Doom956/Robocup-Junoir-Theseus/outputs/original-poster-source.png

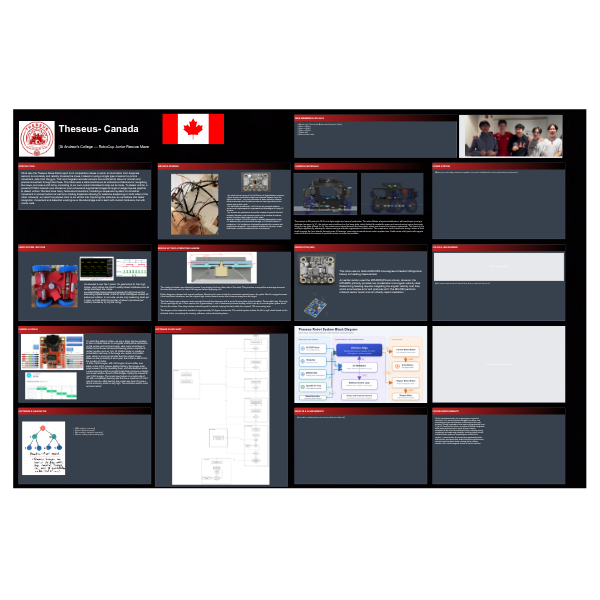
outputs/original-poster-source.png
