Doom956/Robocup-Junoir-Theseus/outputs/diagrams/chrome-profile/Default/README

Google Chrome settings and storage represent user-selected preferences and information and MUST not be extracted, overwritten or modified except through Google Chrome defined APIs.
