Doom956/Robocup-Junoir-Theseus/outputs/diagrams/theseus-system-block-diagram.png

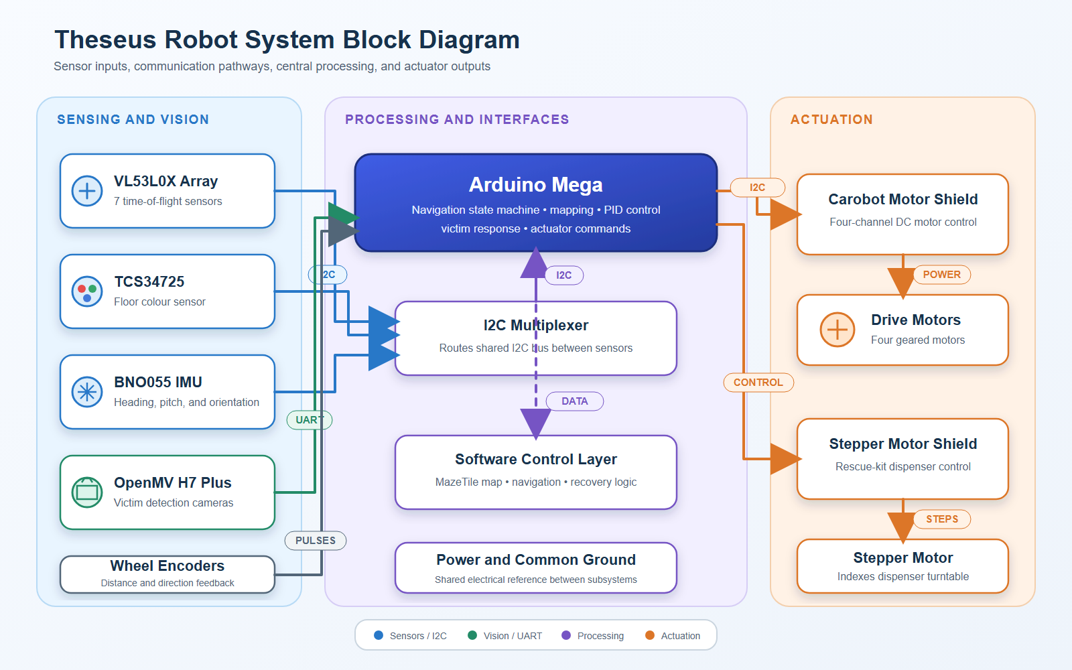
outputs/diagrams/theseus-system-block-diagram.png
