Doom956/Robocup-Junoir-Theseus/outputs/priced-bom/Electronics_Sensor_BOM_Priced.xlsx

Sheet: Summary
Electronics and Sensor Bill of Materials
Prices checked June 12, 2026 | USD unless stated | Tax and shipping excluded
Metric | Value
Partial priced subtotal | $631.07
BOM line items | 23
Rows without complete USD cost | 12
Pricing Notes
The subtotal includes only items with a numeric required quantity and a USD unit price.
Representative prices are assumptions and must be confirmed before ordering.
The CAROBOT shield is listed at CAD $19.99 and is excluded from the USD subtotal.
Resolve the spreadsheet's 150:1 gearmotor description against linked Pololu item 3493, which is 195:1.

Sheet: BOM
Category | Component / Description | Supplier | Status | Type | Required Qty | Existing Qty | Spare Qty | Unit Price (USD) | Required Cost (USD) | Pricing Basis | Assumptions / Follow-up | Source URL
Processing | Processor/controller board (exact model TBD) | Supplier TBD | Reused; existing inventory | Kit/off-the-shelf | 0 | 2 | 1 |  |  | TBD | Exact model required
Sensor | Adafruit VL53L0X time-of-flight sensor breakout, PID 3317 | Adafruit | Reused; existing inventory | Kit/off-the-shelf | 7 | 14 | 1 | $14.95 | $104.65 | Exact | PID 3317 | https://www.adafruit.com/product/3317
Sensor | Adafruit TCS34725 color sensor breakout, PID 1334 | Adafruit | Reused; existing inventory | Kit/off-the-shelf | 1 | 2 | 0 | $7.95 | $7.95 | Listed; discontinued | Discontinued listing | https://www.adafruit.com/product/1334
Sensor | Adafruit BNO055 absolute-orientation sensor breakout, PID 2472 | Adafruit | Reused; existing inventory | Kit/off-the-shelf | 1 | 2 | 0 | $34.95 | $34.95 | Exact | PID 2472 | https://www.adafruit.com/product/2472
Sensor | Motor encoders; assumed Pololu 20D magnetic encoder pair kit, item 3499 | Pololu | Reused; spare inventory; installed quantity unknown | Kit/off-the-shelf | 2 |  | 1 | $9.95 | $19.90 | Representative | Quantity is pair kits; confirm installed model | https://www.pololu.com/product/3499
Vision | OpenMV Cam H7 Plus, SKU OMV-CAM-H7-PLUS-V1 | OpenMV | Reused; existing inventory | Kit/off-the-shelf | 2 | 4 | 0 | $135.00 | $270.00 | Exact; sold out | Production-run order only | https://openmv.io/products/openmv-cam-h7-plus
Actuator | Pololu extended-shaft gearmotor; linked item 3493 is 195:1 | Pololu | Reused; existing inventory | Kit/off-the-shelf | 4 | 8 | 1 | $32.95 | $131.80 | Linked model | Spreadsheet says 150:1; confirm ratio/model | https://www.pololu.com/product/3493
Actuator | 28BYJ-style 5 V geared stepper motor; assumed Adafruit PID 858 | Adafruit | Reused; existing and spare inventory | Kit/off-the-shelf | 1 | 2 | 4 | $4.95 | $4.95 | Representative; out of stock | Confirm exact model | https://www.adafruit.com/product/858
Display | LCD screen (exact model and size TBD) | Supplier TBD | Reused; existing and spare inventory | Kit/off-the-shelf | 1 | 1 | 1 |  |  | TBD | Exact model and size required
Lighting | LED strips (type/length TBD) | Supplier TBD | Reused; existing inventory | Kit/off-the-shelf | 3 | 3 | 0 |  |  | TBD | Type, voltage, density, and length required
Mechanical | M4 suspension screws (length/type TBD) | Supplier TBD | Reused; existing inventory | Kit/off-the-shelf | 1 | 2 | 0 |  |  | TBD | Price is per required set; specification required
Mechanical | Ball bearings (size/model TBD) | Supplier TBD | Reused; existing and spare inventory | Kit/off-the-shelf | 2 | 4 | 5 |  |  | TBD | Size/model required
Mechanical | Motor brackets (exact model TBD) | Supplier TBD | Reused; existing and spare inventory | Kit/off-the-shelf | 4 | 8 | 6 |  |  | TBD | Exact model required
Electronics | Protoboard; assumed Adafruit half-size Perma-Proto, PID 1609 | Adafruit | Reused; existing and spare inventory | Kit/off-the-shelf | 1 | 2 | 1 | $4.50 | $4.50 | Representative | Confirm dimensions | https://www.adafruit.com/product/1609
Wiring | Qwiic cables; assumed 100 mm JST-SH 4-pin, Adafruit PID 4210 | Adafruit | Reused; existing inventory | Kit/off-the-shelf | 10 | 18 | 0 | $0.95 | $9.50 | Representative | Confirm lengths | https://www.adafruit.com/product/4210
Safety/electronics | Circuit breaker (rating/model TBD) | Supplier TBD | Reused; existing and spare inventory | Kit/off-the-shelf | 1 | 1 | 3 |  |  | TBD | Rating/model required
Wiring | Wire clips (type and quantity TBD) | Supplier TBD | Inventory status TBD | Kit/off-the-shelf |  |  |  |  |  | TBD | Type and quantity required
Wiring | JST-PH cables; assumed Pololu 6-pin female-female 10 cm, item 5643 | Pololu | Reused; existing and spare inventory | Kit/off-the-shelf | 4 | 8 | 2 | $3.23 | $12.92 | Representative | Confirm pin count and length | https://www.pololu.com/category/361/6-pin-jst-ph-style-cables
Power | Pololu D24V50F5 5 V step-down voltage regulator, item 2851 | Pololu | Reused; existing inventory; verify possible school spares | Kit/off-the-shelf | 1 | 1 | 0 | $29.95 | $29.95 | Exact | Item 2851 | https://www.pololu.com/product/2851
Control | CAROBOT Motor Shield V3, SKU 2337 | Canada Robotix | Reused; quantity must be verified | Kit/off-the-shelf |  |  |  |  |  | CAD price only | CAD $19.99; USD price and required quantity TBD | https://www.canadarobotix.com/products/2337
Control | SparkFun Qwiic Mux Breakout - 8 Channel (TCA9548A), BOB-16784 | SparkFun | Reused; quantity must be verified | Kit/off-the-shelf |  |  |  | $6.95 |  | Exact | Required quantity TBD | https://www.sparkfun.com/sparkfun-qwiic-mux-breakout-8-channel-tca9548a.html
Power | LiPo battery (voltage, capacity, and model TBD) | Supplier TBD | Reused; quantity and condition must be verified | Kit/off-the-shelf |  |  |  |  |  | TBD | Voltage, capacity, model, and quantity required
Assembly | Robot mechanical structure and wiring assembly | Team designed and assembled | Reused; verify current configuration | Custom-built | 1 |  |  |  |  | TBD | Material costs TBD
