Doom956/Robocup-Junoir-Theseus/docs/BoM for worlds.xlsx

Sensors:
 | Need(What we need) | existing(how many already exist on the robots) | Spare(how many we have extra not on the robot) | Unit price / listed currency | Price source / assumption | Price checked
Processors | 0 | 2 | 1 | TBD | Exact processor/controller model required | 2026-06-12
Sensors:
Vl53L0X | 7 | 14 | 1 | $14.95 | Adafruit PID 3317: https://www.adafruit.com/product/3317 | 2026-06-12
TCS34725 | 1 | 2 | 0 | $7.95 | Adafruit PID 1334; discontinued: https://www.adafruit.com/product/1334 | 2026-06-12
BNO055 | 1 | 2 | 0 | $34.95 | Adafruit PID 2472: https://www.adafruit.com/product/2472 | 2026-06-12
Encoders | 2(packs) | ? | 1(pack) | $9.95 | Representative: Pololu item 3499 encoder pair kit; confirm model: https://www.pololu.com/product/3499 | 2026-06-12
Openmv h7 plus | 2 | 4 | 0 | $135.00 | OpenMV H7 Plus; sold out / production-run order only: https://openmv.io/products/openmv-cam-h7-plus | 2026-06-12
Actuators:
150:1 Polulu gearmotor with extended shafts | 4 | 8 | 1 | $32.95 | Linked Pololu item 3493 is 195:1, not spreadsheet's 150:1; confirm model: https://www.pololu.com/product/3493 | 2026-06-12
28BYJ-49 stepper motor | 1 | 2 | 4 at my house | $4.95 | Representative: Adafruit PID 858; out of stock; confirm exact model: https://www.adafruit.com/product/858 | 2026-06-12
LCD screen | 1 | 1 | 1 at my house | TBD | Exact LCD model and size required | 2026-06-12
LED strips | 3 | 3 | 0 | TBD | LED strip type, voltage, density, and length required | 2026-06-12
Mechanical&wiring | 3
M4 screws for suspension | 1 | 2 | 0 | TBD | M4 screw length, head type, and pack size required | 2026-06-12
Ball Bearings | 2 | 4 | 5 | TBD | Bearing size/model required | 2026-06-12
Motor Brackets | 4 | 8 | 6 | TBD | Motor bracket model required | 2026-06-12
Protoboard | 1 | 2 | 1 | $4.50 | Representative: Adafruit half-size Perma-Proto PID 1609; confirm dimensions: https://www.adafruit.com/product/1609 | 2026-06-12
Qwiic cables | 10 | 18 | 0 | $0.95 | Assumption: Adafruit PID 4210 100mm Qwiic cable; confirm lengths: https://www.adafruit.com/product/4210 | 2026-06-12
Circuit breaker | 1 | 1 | 3 | TBD | Circuit-breaker rating/model required | 2026-06-12
Wire clips | ??? | ??? | ??? | TBD | Wire-clip type and quantity required | 2026-06-12
JST-PH | 4 | 8 | 2 | $3.23 | Representative: Pololu item 5643 6-pin JST-PH female-female 10cm; confirm pin count/length: https://www.pololu.com/category/361/6-pin-jst-ph-style-cables | 2026-06-12
D24V50F5 5V step-down regulator | 1 | 1 | 0( May be some at the school) | $29.95 | Pololu item 2851: https://www.pololu.com/product/2851 | 2026-06-12
