Doom956/Robocup-Junoir-Theseus/outputs/diagrams/theseus-system-block-diagram.pdf

# Theseus Robot System Block Diagram

## VL53L0X Array

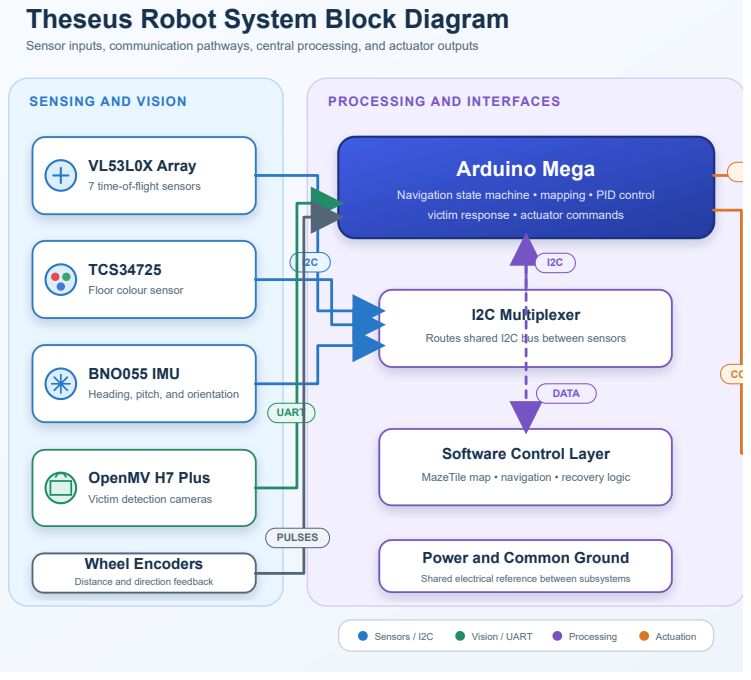
[picture p12: page 1]
SENSING AND VISION; PROCESSING AND INTERFACES; Arduino Mega; I2C Multiplexer; UART; PULSES; DATA; Sensors / I2C; Vision / UART; Processing; Actuation

Sensor inputs, communication pathways, central processing, and actuator outputs

7 time-of-flight sensors

Navigation state machine • mapping • PID control
victim response • actuator commands

TCS34725
Floor colour sensor

Routes shared I2C bus between sensors

BNO055 IMU
Heading, pitch, and orientation

Software Control Layer

OpenMV H7 Plus
Victim detection cameras

MazeTile map • navigation • recovery logic

Wheel Encoders
Distance and direction feedback

Power and Common Ground

Shared electrical reference between subsystems
