Doom956/Robocup-Junoir-Theseus/Main/uart_camera_comms.ino

// camera communication code
// clear serial buffers.

void lcdPrint(const char* msg) {
  lcdMutex.lock();
  lcd.setCursor(0, 0);
  lcd.print("                ");
  lcd.print("                ");
  lcd.setCursor(0, 0);
  lcd.print(msg);
  delay(1000);
  lcd.setCursor(0, 0);
  lcd.print("                ");
  lcd.print("                ");
  lcd.setCursor(0, 0);
  lcdMutex.unlock();
}

void clearSerialBuffer1() {
  while (Serial4.available() > 0) {
    Serial4.read();  // Read and discard one byte from the buffer
  }
}
void clearSerialBuffer2() {
  while (Serial3.available() > 0) {
    Serial3.read();  // Read and discard one byte from the buffer
  }
}

// classify a single camera byte: H/S/U = victim (0/1/2),
// L/c/I = camera "searching"/circle signal (-2), anything else -2.
int classifyCamByte(char sample){
  if(sample == 'H') return 0;
  if(sample == 'S') return 1;
  if(sample == 'U') return 2;
  return -2; // L / c / I / stray byte -> not a lettered victim
}
int readSerial1(){ // left
  // The camera streams continuously, so the RX FIFO backs up while we move.
  // Drain everything and keep only the NEWEST byte so we react to what the
  // camera sees now, not a byte from several frames (and tiles) ago.
  if(Serial4.available() <= 0) return -1; // nothing right now
  char sample = 0;
  while(Serial4.available() > 0){
    sample = Serial4.read();
  }
  return classifyCamByte(sample);
}
int readSerial2(){ //right
  if(Serial3.available() <= 0) return -1; // nothing right now
  char sample = 0;
  while(Serial3.available() > 0){
    sample = Serial3.read();
  }
  return classifyCamByte(sample);
}
void detectCam1(){ // left camera serial4
   // read buffer
  // if there is content, take 5 samples and take the most common letter.
  int samples[5];
  int n = 0;
  int maxCount = 0;
  char res = 0;
  char output;
  timer myTimer;
  while(n<5){
    if(myTimer.getTime() > 4*1000000) return;
    
    int value = readSerial1();
    
    if(value >= 0){   // only H/S/U
        samples[n] = value;
        Serial.println(value);
        n++;
    }
  }
  for(int i =0; i<5;i++){
    Serial.println(samples[i]);
  }
  
  for(int i=0;i<6;i++){
    int count = 0;
    for(int j = 0;j<5;j++){
      if(samples[j] == i) count++;
    }
    if(count > maxCount){
      maxCount = count;
      res = classes[i];
    }
  }
  
  char msg[17]; snprintf(msg, sizeof(msg), "victim: %c", res);
  lcdPrint(msg);
  
  disp.dispenseLeft(res);
  return;
}
void detectCam2(){
  // read buffer
  // if there is content, take 5 samples and take the most common letter.
  int samples[5];
  int n = 0;
  int maxCount = 0;
  char res = 0;
  char output;
  timer myTimer;
  while(n<5){
    if(myTimer.getTime() > 4*1000000) return;
    
    int value = readSerial2();

    if(value >= 0){   // only H/S/U
        samples[n] = value;
        Serial.println(value);
        n++;
    }
  }
  for(int i =0; i<5;i++){
    Serial.println(samples[i]);
  }
  
  for(int i=0;i<6;i++){
    int count = 0;
    for(int j = 0;j<5;j++){
      if(samples[j] == i) count++;
    }
    if(count > maxCount){
      maxCount = count;
      res = classes[i];
    }
  }
  char msg[17]; snprintf(msg, sizeof(msg), "victim: %c", res);
  lcdPrint(msg);
  
  disp.dispenseRight(res);
  return;
}
// Service a camera victim that the RTOS thread flagged via victimPending.
// The caller (fwd/absoluteturn) has already paused its PID + timer. This stops
// the drivetrain, identifies the victim on the wall, dispenses the rescue kit,
// and labels the correct tile using the encoder position. (claude version 6/16/2026)
// serviceCameraVictim() is outside to prevent I2C conflict with centered.
void serviceCameraVictim(){
  drivetrain.fullstop();
  if(victimSide == 1){            // left camera (Serial3)
    if(detectWall(3) == 0){       // RCJ victims are wall-mounted
      Serial.println("victim at left");
      clearSerialBuffer1();
      detectCam1();
      markVictimAtEncoderPosition(TILE_MM);
      victimtoggle = true;
    }
  }
  else if(victimSide == 2){       // right camera (Serial2)
    if(detectWall(1) == 0){
      Serial.println("victim at right");
      clearSerialBuffer2();
      detectCam2();
      markVictimAtEncoderPosition(TILE_MM);
      victimtoggle = true;
    }
  }
  isVictim = true;       // at most one victim serviced per move
  victimPending = false; // re-enable the camera thread
}
void detect(){ // the robot goes forward until it detects something( does not return)
  drivetrain.fullstop();
  bool victimAtLeft = false; // victim at left
  bool victimAtRight = false; // victim at right
  // clear buffers
  clearSerialBuffer1();
  clearSerialBuffer2();
  // don't detect if there is no wall( prevent misdetection)
  bool wallAtLeft = false;
  bool wallAtRight = false;
  int right = measure(3);
  int left = measure(6);
  if(right <MIN_DIST&&right!=-1) wallAtRight = true;
  if(left<MIN_DIST&&right!=-1) wallAtLeft = true;
  if(wallAtRight == false && wallAtLeft == false) return;
  timer myTimer;
  while(true){
    if(readSerial1() != -1&&wallAtLeft == true){
      Serial.println("left");
      victimAtLeft = true;
      victimtoggle = true;
      break;
    }
    if(readSerial2() != -1&&wallAtRight == true){
      Serial.println("right");
      victimAtRight = true;
      victimtoggle = true;
      break;
    }
    if(myTimer.getTime() >= 1000000*1.2) break; // give 1.5 seconds to detect.
    drivetrain.fw(80);
  }
  drivetrain.fullstop();
  delay(200);
  if(victimAtLeft == true){
    
    detectCam1();
  }
  else if(victimAtRight == true){
    
    detectCam2();
  }
  
  // backpedal
  while(drivetrain.encoderCountA > 0){
    drivetrain.backward(100);
  }
  drivetrain.fullstop();

}
