Doom956/Robocup-Junoir-Theseus/Main/color.ino

void init_color(){
  //tcs.setInterrupt(true);
  myMux.setPort(TCS_PORT);
  //digitalWrite(POWERPIN,HIGH);
  //tcs.enable();
  if (tcs.begin()) {
    Serial.println("Found tcs34725 sensor");
    
  } else {
    Serial.println("No TCS34725 found ... check your connections");
  
    
    
    //while (1); // halt!
  }
  myMux.setPort(TCS_PORT);          
  tcs.setInterrupt(true);  // turn on LED
  float red, green, blue;
  uint16_t r, g, b, c, colorTemp, lux;

  tcs.getRawData(&r, &g, &b, &c);
  clear = c;
  Serial.println("clear value");
  Serial.println(clear);
  
}
int read_color(){
  i2cMutex.lock();
  myMux.setPort(TCS_PORT);
  tcs.setInterrupt(true);  // turn on LED
  float red, green, blue;
  uint16_t r, g, b, c, colorTemp, lux;

  tcs.getRawData(&r, &g, &b, &c);
  i2cMutex.unlock();
  /*
  Serial.print(r);
  Serial.print(" ");
  Serial.print(g);
  Serial.print(" ");
  Serial.print(b);
  Serial.print(" ");
  */
  Serial.println(c/clear);
  
  if((float)c/clear<BLACK_THRESHOLD){
    
    
    return -1; // black
  }
  if((float)c/clear>WHITE_THRESHOLD) return 0;
  if((float)c/clear>SILVER_THRESHOLD){
    int nx = x_pos; int ny = y_pos;
    stepForward(currentDir,nx,ny);
    Serial.print("silver at ");
    Serial.print(nx);
    Serial.print(", y=");
    Serial.print(ny);
    mapGrid[nx][ny].setType(CHECKPOINT);
    x_checkpoint = nx; y_checkpoint = ny;
    floor_checkpoint = currentFloor; // remember which floor this checkpoint is on

    return 3; // SILVER — prevent fall-through into blue/red checks
  }
  
  if(b>g+10&&b>r+10) return 1; //blue
    
  if(r>g+10&&r>b+10) return 2;

}
  
