Doom956/Robocup-Junoir-Theseus/(commit log)

2026-04-17 fix: add missing break to VICTIM_DETECT case
    [Main.ino]
2026-04-20 fix: apply all remaining bug fixes and navigation improvements
    - PID.cpp: clamp cumError to ±1000 to prevent integral windup
    - movement.ino: fix adjustment variable shadowing in ramp block;
    fix victim detection wall checks (==0 not ==1); call drivetrain.fullstop()
    correctly; mark black tile direction as permanently walled
    - navigation.ino: move dir[][] before functions that use it; replace
    ArduinoQueue with static fixed-size array queues in BFS and
    pickNextDirectionBFS; make all large arrays static to avoid stack
    overflow on 8KB Mega SRAM; add unreachable-destination guard in BFS;
    fix firstStep propagation in pickNextDirectionBFS
    - Main.ino: fix PAUSE state being overwritten in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
    [Main.ino, PID.cpp, movement.ino, navigation.ino]
2026-04-20 fix: correct double abs() truncation and PID zero-dt divide-by-zero
    - Main.ino: headingErrorDeg() used abs() which truncates double to int
    on Arduino; replaced with fabs() so turn tolerance check is accurate
    - PID.cpp: guard against division by zero when currentTime == previousTime
    (can occur on first call or rapid successive calls); delta defaults to
    0.0 in that case rather than crashing or producing garbage
    [Main.ino, PID.cpp]
2026-05-06 fix navigation bugs: state machine, blue/silver tiles, BFS, RETURN path
    - Add missing break in VICTIM_DETECT to stop fall-through into PLAN_NEXT
    - Move stepForward before blue tile check so setBlue marks the correct
    (newly entered) tile instead of the tile just left
    - Fix silver tile detection: threshold was 800 but c/clear ratio is ~0-3,
    changed to 1.5f; add return 3 to prevent fall-through into blue check
    - Fix RETURN state: currentDir was hardcoded to WEST (3) for both NORTH
    and SOUTH moves; corrected to NORTH (0) and SOUTH (2) respectively
    - Fix RETURN path loop off-by-one: was accessing path[length] (OOB),
    now starts at path[length-1]
    - Add BFS reachability check: return 0 if en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
    [Main.ino, color.ino, navigation.ino]
2026-05-27 5/27/2026 version
    bugged, for the red robot.
    [Distance.ino, Main.ino, color.ino, movement.ino, uart_camera_comms.ino]
2026-06-12 update bom
    [BoM for worlds.xlsx]
2026-06-17 claude version 6/16/2026: port multicore navigation/loop to single-core main
    - Copy multicore_version navigation.ino into main; replace all RPC.call(...)
    cross-core calls with the original single-core functions
    (drivetrain.encoderCountA, detectWall, parallel, headingToCardinal, ...).
    - Add multi-floor elevation features: Grid type (std::array) + m1/m2/m3 floor
    grids, Tile setElevate/setDescend, elevation()/descend(), and m1/m2/m3 shifts
    in reallocate()/initTile(). MAP_SIZE + Grid moved to MazeTile.h so the type is
    visible to Arduino's generated prototypes.
    - Port the "more bug fixes" state-machine loop: reset toggles in SENSE_TILE,
    correct blue-tile (5s stop on the entered tile)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
    [Main.ino, MazeTile.h, movement.ino, navigation.ino, uart_camera_comms.ino]
2026-06-19 6/19/2026 push
    camera thread working
    corrected serial
    added third encoder.
    fixed climbing
    [Distance.ino, Main.ino, color.ino, gyro.cpp, motors.cpp, motors.h, movement.ino, uart_camera_comms.ino]
2026-06-21 6/21/2026 version
    increased os prioritization given to camera thread.
2026-06-22 6/22/2026 version
    - got rid of stairs type
    - fixed elevate and descend
    reallocate needs work
    [Main.ino, MazeTile.h, movement.ino, navigation.ino]
